Bragendesh/RB-Macro16/README.md

# RB-Macro16
A basic 16-key macropad with an optional spot for a rotary encoder and per-key RGB backlighting
