Bragendesh/RB-Macro16/232202_RB-Macro16_Schematic.png

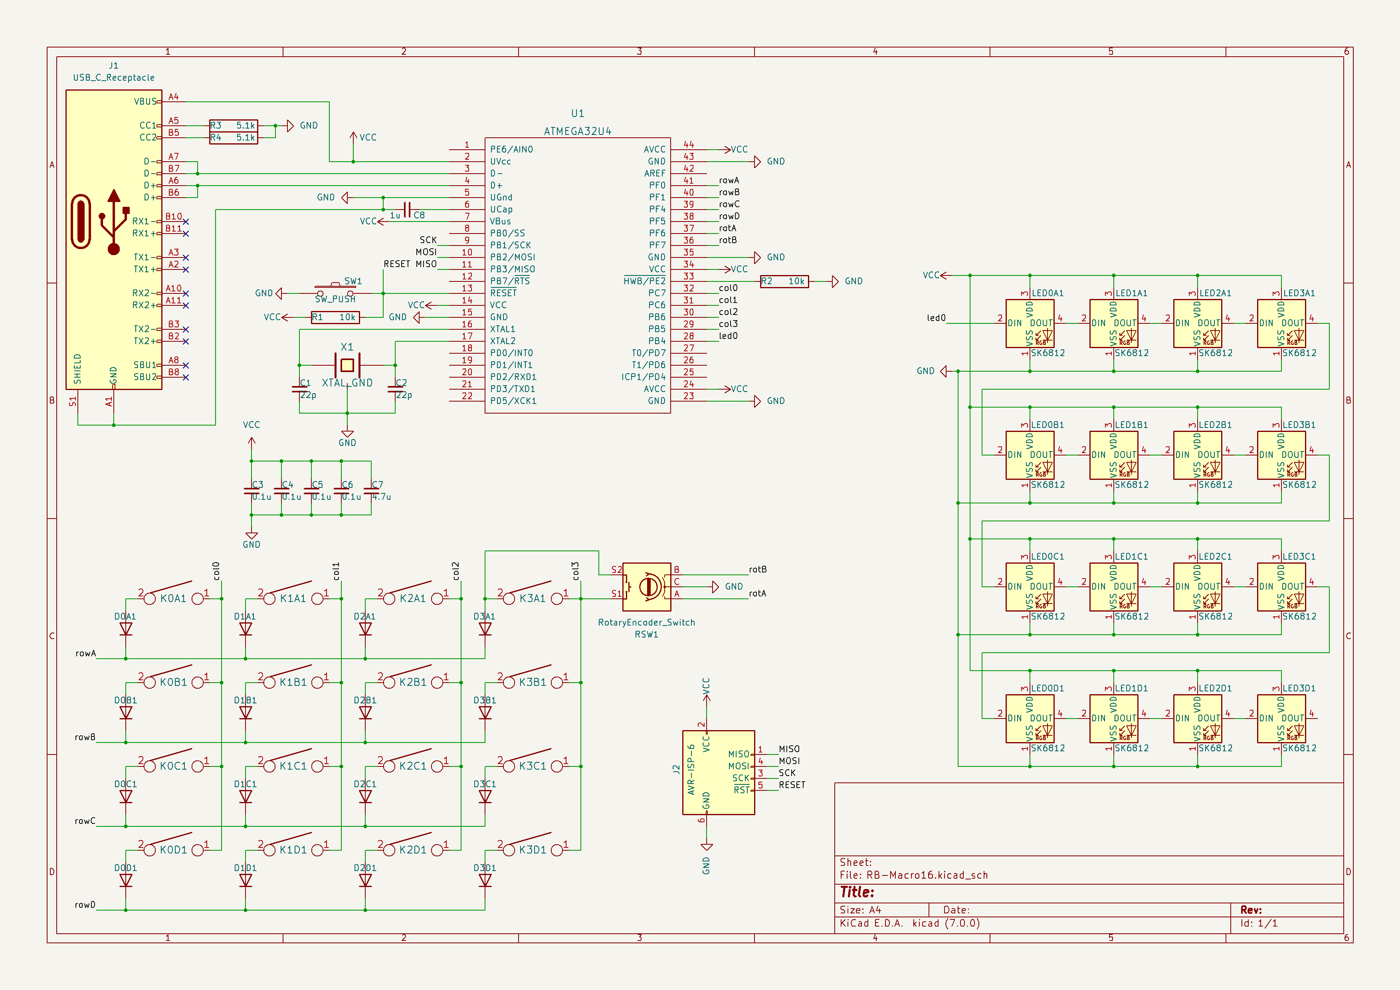
232202_RB-Macro16_Schematic.png
