Bragendesh/RB-Macro16/KiCad Project/RB-Macro16.kicad_pcb

## KiCad design KiCad Project/RB-Macro16.kicad_pcb (2023-03-09)

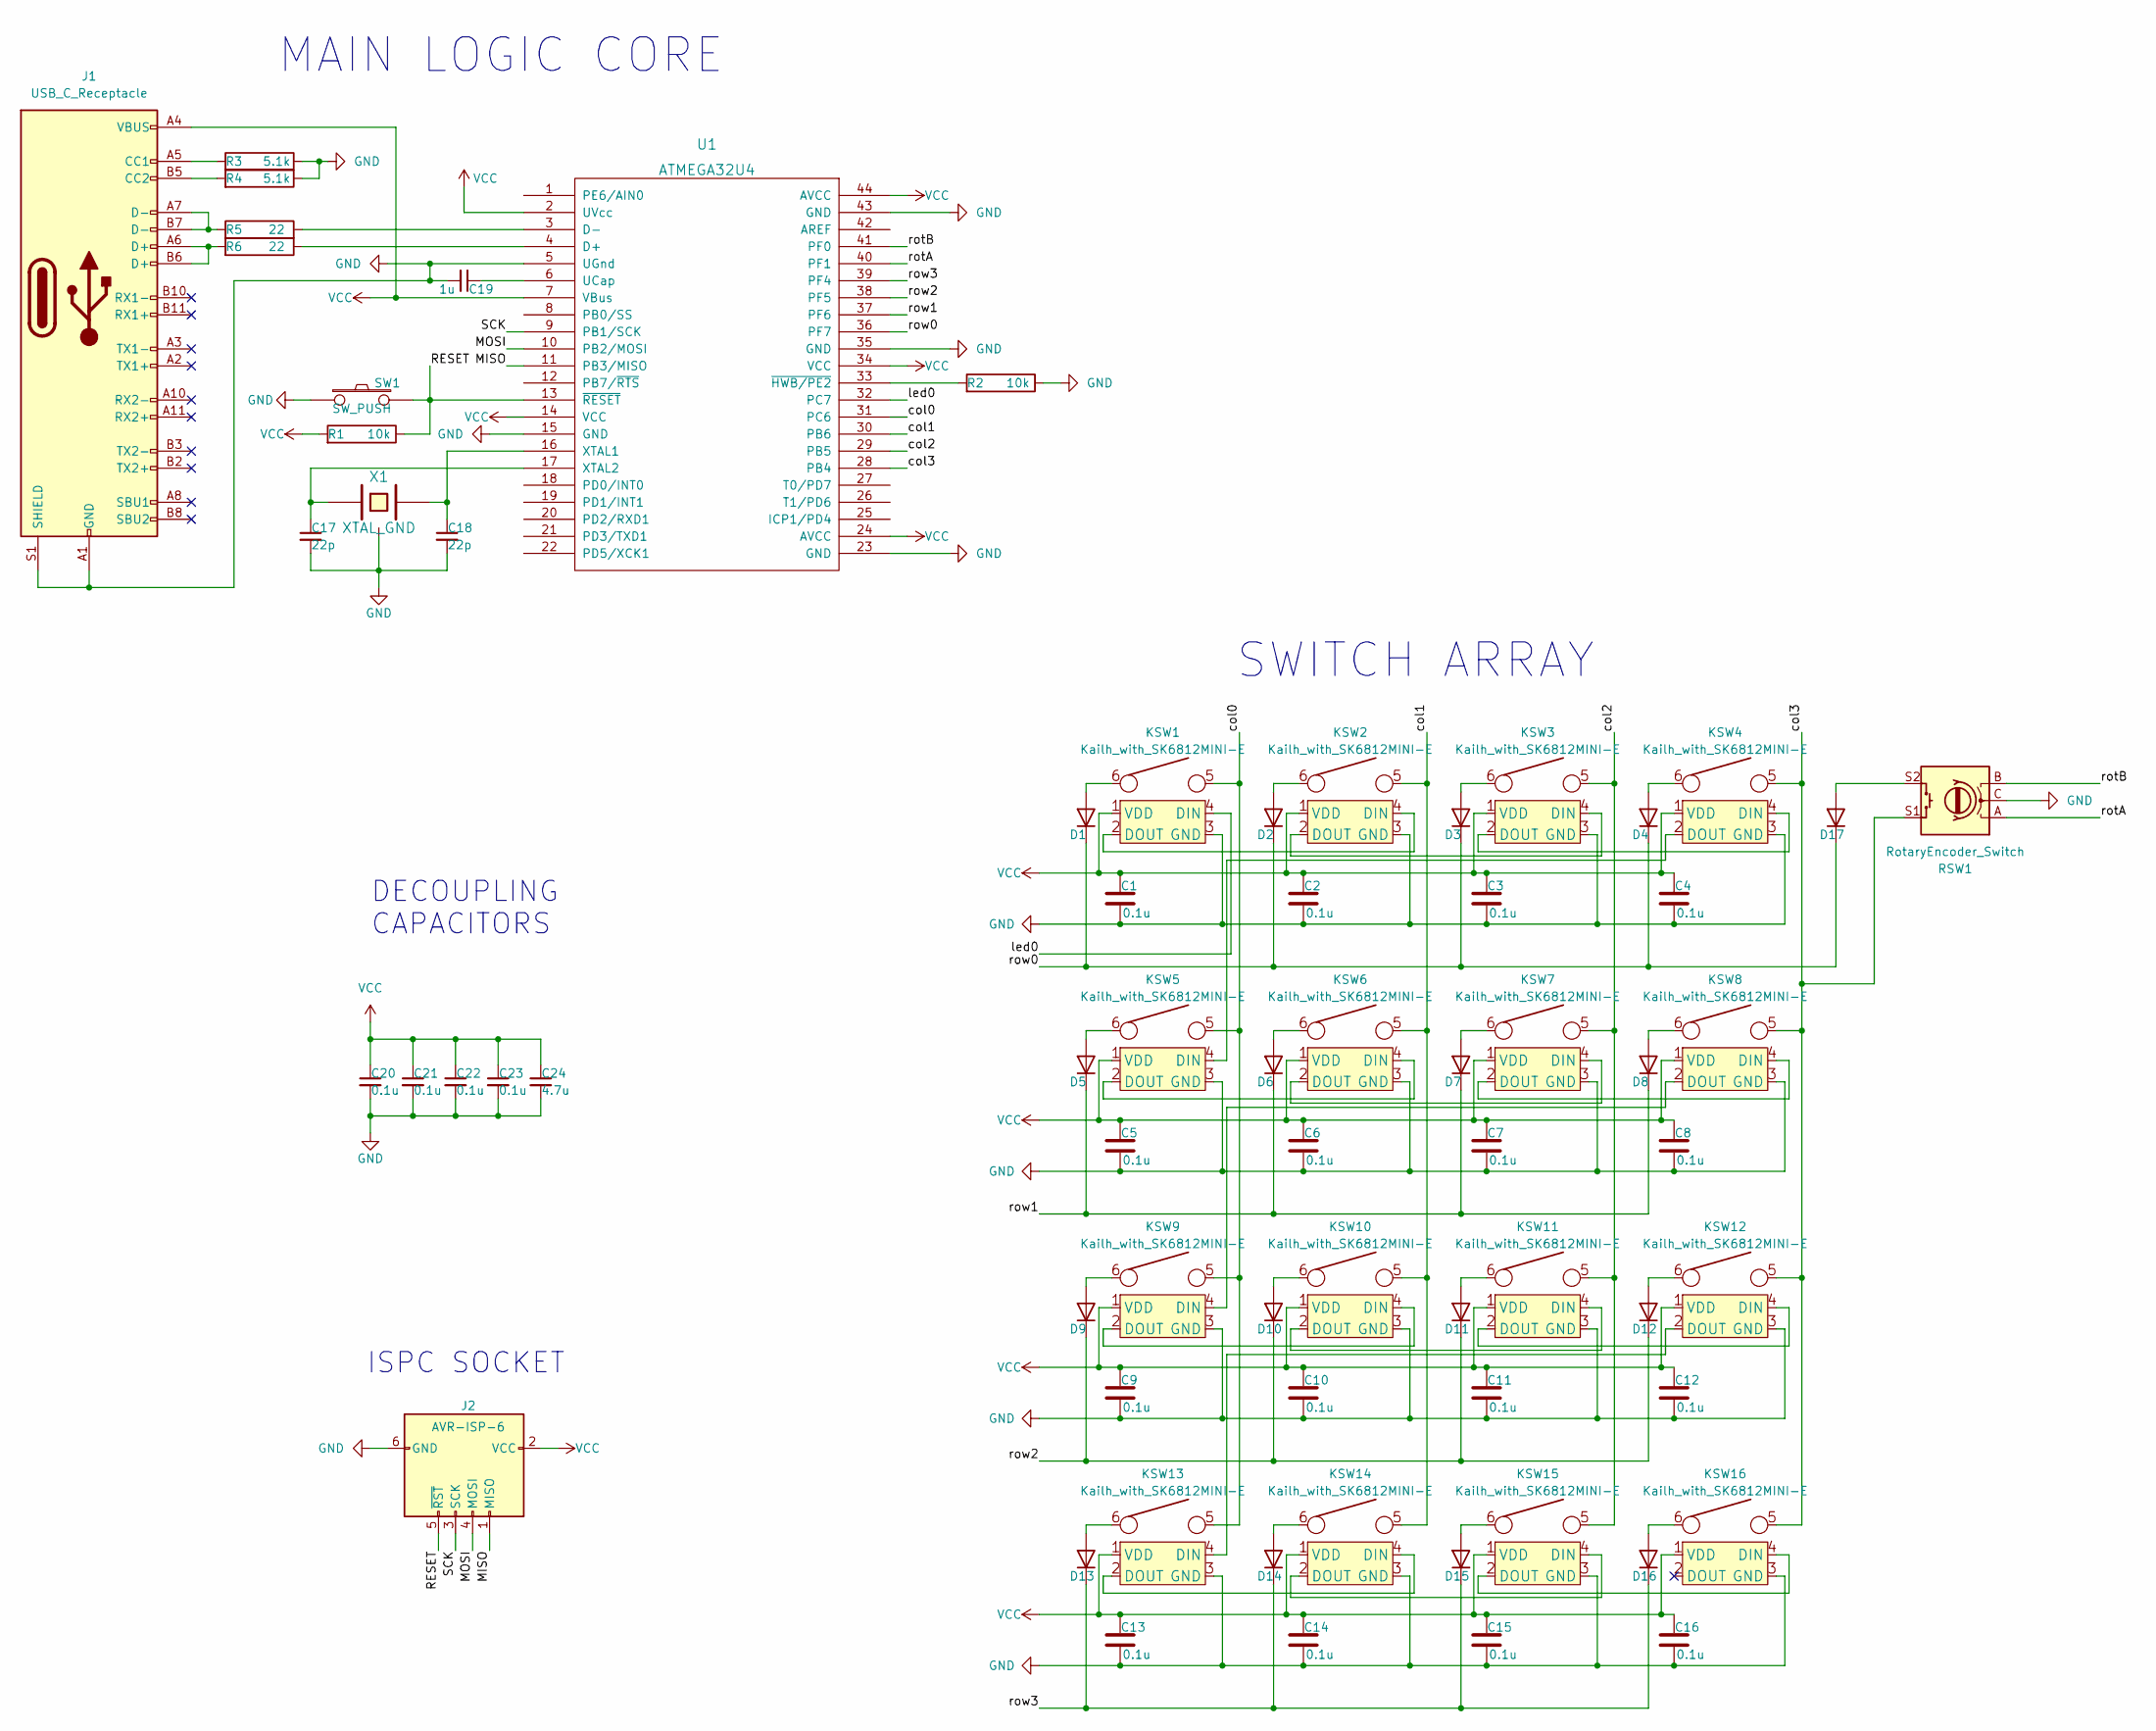
[picture p2: schematic RB-Macro16.kicad_sch]

Parts:
C1, C2, C3, C4, C5, C6, C7, C8, C9, C10, C11, C12, C13, C14, C15, C16, C20, C21, C22, C23: 0.1u; C_0805_2012Metric_Pad1.18x1.45mm_HandSolder
C17, C18: 22p; C_0805_2012Metric_Pad1.18x1.45mm_HandSolder
C19: 1u; C_0805_2012Metric_Pad1.18x1.45mm_HandSolder
C24: 4.7u; C_0805_2012Metric_Pad1.18x1.45mm_HandSolder
D1, D2, D3, D4, D5, D6, D7, D8, D9, D10, D11, D12, D13, D14, D15, D16, D17: D; D_SOD-123
J1: USB_C_Receptacle; USB_C_Receptacle_Amphenol_12401610E4-2A
J2: AVR-ISP-6; AVR_ICSP_3x2
KSW1, KSW2, KSW3, KSW4, KSW5, KSW6, KSW7, KSW8, KSW9, KSW10, KSW11, KSW12, KSW13, KSW14, KSW15, KSW16: Kailh_with_SK6812MINI-E
R1, R2: 10k; R_Axial_DIN0207_L6.3mm_D2.5mm_P7.62mm_Horizontal
R3, R4: 5.1k; R_Axial_DIN0207_L6.3mm_D2.5mm_P7.62mm_Horizontal
R5, R6: 22; R_Axial_DIN0207_L6.3mm_D2.5mm_P7.62mm_Horizontal
RSW1: RotaryEncoder_Switch; RotaryEncoder_Alps_EC12E-Switch_Vertical_H20mm
SW1: SW_PUSH; SW_PUSH_6mm
U1: ATMEGA32U4; TQFP-44_10x10mm_P0.8mm
X1: XTAL_GND; Crystal_SMD_SeikoEpson_FA238-4Pin_3.2x2.5mm_HandSoldering

Connections:
/MISO: J2.1 (MISO), U1.11 (PB3/MISO)
/MOSI: J2.4 (MOSI), U1.10 (PB2/MOSI)
/RESET: J2.5 (~RST), R1.2, SW1.2, U1.13 (~RESET)
/SCK: J2.3 (SCK), U1.9 (PB1/SCK)
/col0: KSW1.5, KSW5.5, KSW9.5, KSW13.5, U1.31 (PC6)
/col1: KSW2.5, KSW6.5, KSW10.5, KSW14.5, U1.30 (PB6)
/col2: KSW3.5, KSW7.5, KSW11.5, KSW15.5, U1.29 (PB5)
/col3: KSW4.5, KSW8.5, KSW12.5, KSW16.5, RSW1.S1, U1.28 (PB4)
/led0: KSW1.4 (DIN), U1.32 (PC7)
/rotA: RSW1.A, U1.40 (PF1)
/rotB: RSW1.B, U1.41 (PF0)
/row0: D1.1 (K), D2.1 (K), D3.1 (K), D4.1 (K), D17.1 (K), U1.36 (PF7)
/row1: D5.1 (K), D6.1 (K), D7.1 (K), D8.1 (K), U1.37 (PF6)
/row2: D9.1 (K), D10.1 (K), D11.1 (K), D12.1 (K), U1.38 (PF5)
/row3: D13.1 (K), D14.1 (K), D15.1 (K), D16.1 (K), U1.39 (PF4)
GND: C1.2, C2.2, C3.2, C4.2, C5.2, C6.2, C7.2, C8.2, C9.2, C10.2, C11.2, C12.2, C13.2, C14.2, C15.2, C16.2, C17.2, C18.2, C19.2, C20.2, C21.2, C22.2, C23.2, C24.2, J1.A1 (GND), J1.A12 (GND), J1.B1 (GND), J1.B12 (GND), J1.S1 (SHIELD), J2.6 (GND), KSW1.3 (GND), KSW2.3 (GND), KSW3.3 (GND), KSW4.3 (GND), KSW5.3 (GND), KSW6.3 (GND), KSW7.3 (GND), KSW8.3 (GND), KSW9.3 (GND), KSW10.3 (GND), KSW11.3 (GND), KSW12.3 (GND), KSW13.3 (GND), KSW14.3 (GND), KSW15.3 (GND), KSW16.3 (GND), R2.2, R3.2, R4.2, RSW1.C, SW1.1, U1.5 (UGnd), U1.15 (GND), U1.23 (GND), U1.35 (GND), U1.43 (GND), X1.3
unnamed: D1.2 (A), KSW1.6
unnamed: D2.2 (A), KSW2.6
unnamed: D3.2 (A), KSW3.6
unnamed: D4.2 (A), KSW4.6
unnamed: D5.2 (A), KSW5.6
unnamed: D6.2 (A), KSW6.6
unnamed: D7.2 (A), KSW7.6
unnamed: D8.2 (A), KSW8.6
unnamed: D9.2 (A), KSW9.6
unnamed: D10.2 (A), KSW10.6
unnamed: D11.2 (A), KSW11.6
unnamed: D12.2 (A), KSW12.6
unnamed: D13.2 (A), KSW13.6
unnamed: D14.2 (A), KSW14.6
unnamed: D15.2 (A), KSW15.6
unnamed: D16.2 (A), KSW16.6
unnamed: D17.2 (A), RSW1.S2
unnamed: J1.A5 (CC1), R3.1
unnamed: J1.B5 (CC2), R4.1
unnamed: J1.A6 (D+), J1.B6 (D+), R6.1
unnamed: J1.A7 (D-), J1.B7 (D-), R5.1
unnamed: KSW1.2 (DOUT), KSW2.4 (DIN)
unnamed: KSW2.2 (DOUT), KSW3.4 (DIN)
unnamed: KSW3.2 (DOUT), KSW4.4 (DIN)
unnamed: KSW4.2 (DOUT), KSW5.4 (DIN)
unnamed: KSW5.2 (DOUT), KSW6.4 (DIN)
unnamed: KSW6.2 (DOUT), KSW7.4 (DIN)
unnamed: KSW7.2 (DOUT), KSW8.4 (DIN)
unnamed: KSW8.2 (DOUT), KSW9.4 (DIN)
unnamed: KSW9.2 (DOUT), KSW10.4 (DIN)
unnamed: KSW10.2 (DOUT), KSW11.4 (DIN)
unnamed: KSW11.2 (DOUT), KSW12.4 (DIN)
unnamed: KSW12.2 (DOUT), KSW13.4 (DIN)
unnamed: KSW13.2 (DOUT), KSW14.4 (DIN)
unnamed: KSW14.2 (DOUT), KSW15.4 (DIN)
unnamed: KSW15.2 (DOUT), KSW16.4 (DIN)
unnamed: R6.2, U1.4 (D+)
unnamed: R5.2, U1.3 (D-)
unnamed: C19.1, U1.6 (UCap)
unnamed: C18.1, U1.16 (XTAL1), X1.2
unnamed: C17.1, U1.17 (XTAL2), X1.1
unnamed: R2.1, U1.33 (~HWB/PE2)
VCC: C1.1, C2.1, C3.1, C4.1, C5.1, C6.1, C7.1, C8.1, C9.1, C10.1, C11.1, C12.1, C13.1, C14.1, C15.1, C16.1, C20.1, C21.1, C22.1, C23.1, C24.1, J1.A4 (VBUS), J1.A9 (VBUS), J1.B4 (VBUS), J1.B9 (VBUS), J2.2 (VCC), KSW1.1 (VDD), KSW2.1 (VDD), KSW3.1 (VDD), KSW4.1 (VDD), KSW5.1 (VDD), KSW6.1 (VDD), KSW7.1 (VDD), KSW8.1 (VDD), KSW9.1 (VDD), KSW10.1 (VDD), KSW11.1 (VDD), KSW12.1 (VDD), KSW13.1 (VDD), KSW14.1 (VDD), KSW15.1 (VDD), KSW16.1 (VDD), R1.1, U1.2 (UVcc), U1.7 (VBus), U1.14 (VCC), U1.24 (AVCC), U1.34 (VCC), U1.44 (AVCC)

Notes on the sheet:
MAIN LOGIC CORE
ISPC SOCKET
DECOUPLING CAPACITORS
SWITCH ARRAY

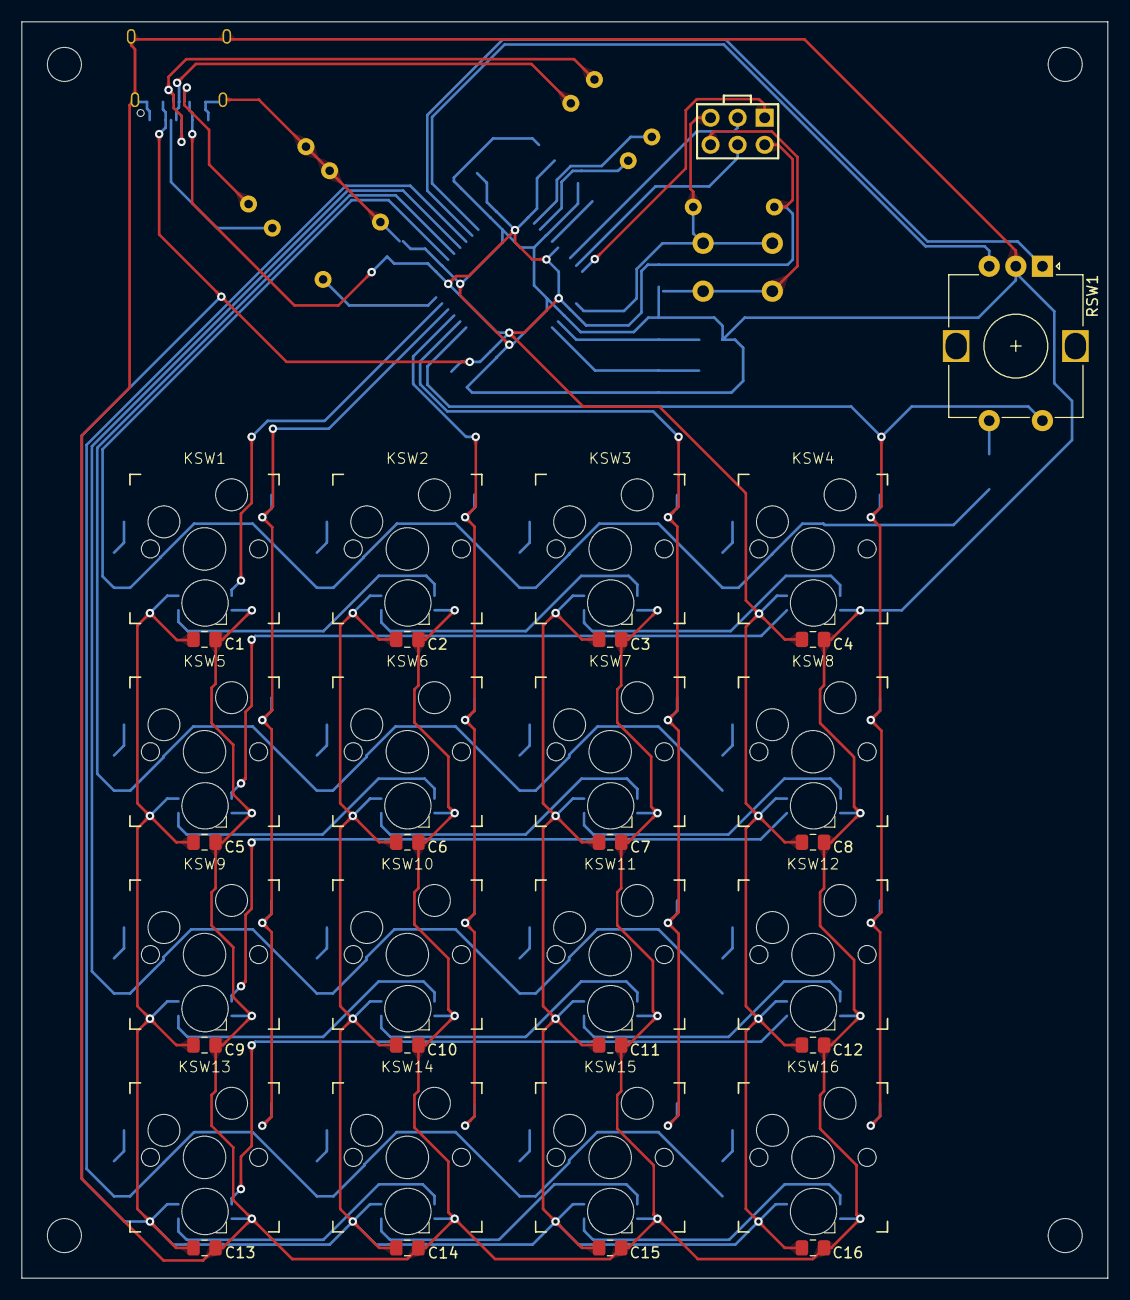
[picture p3: board RB-Macro16.kicad_pcb from above]

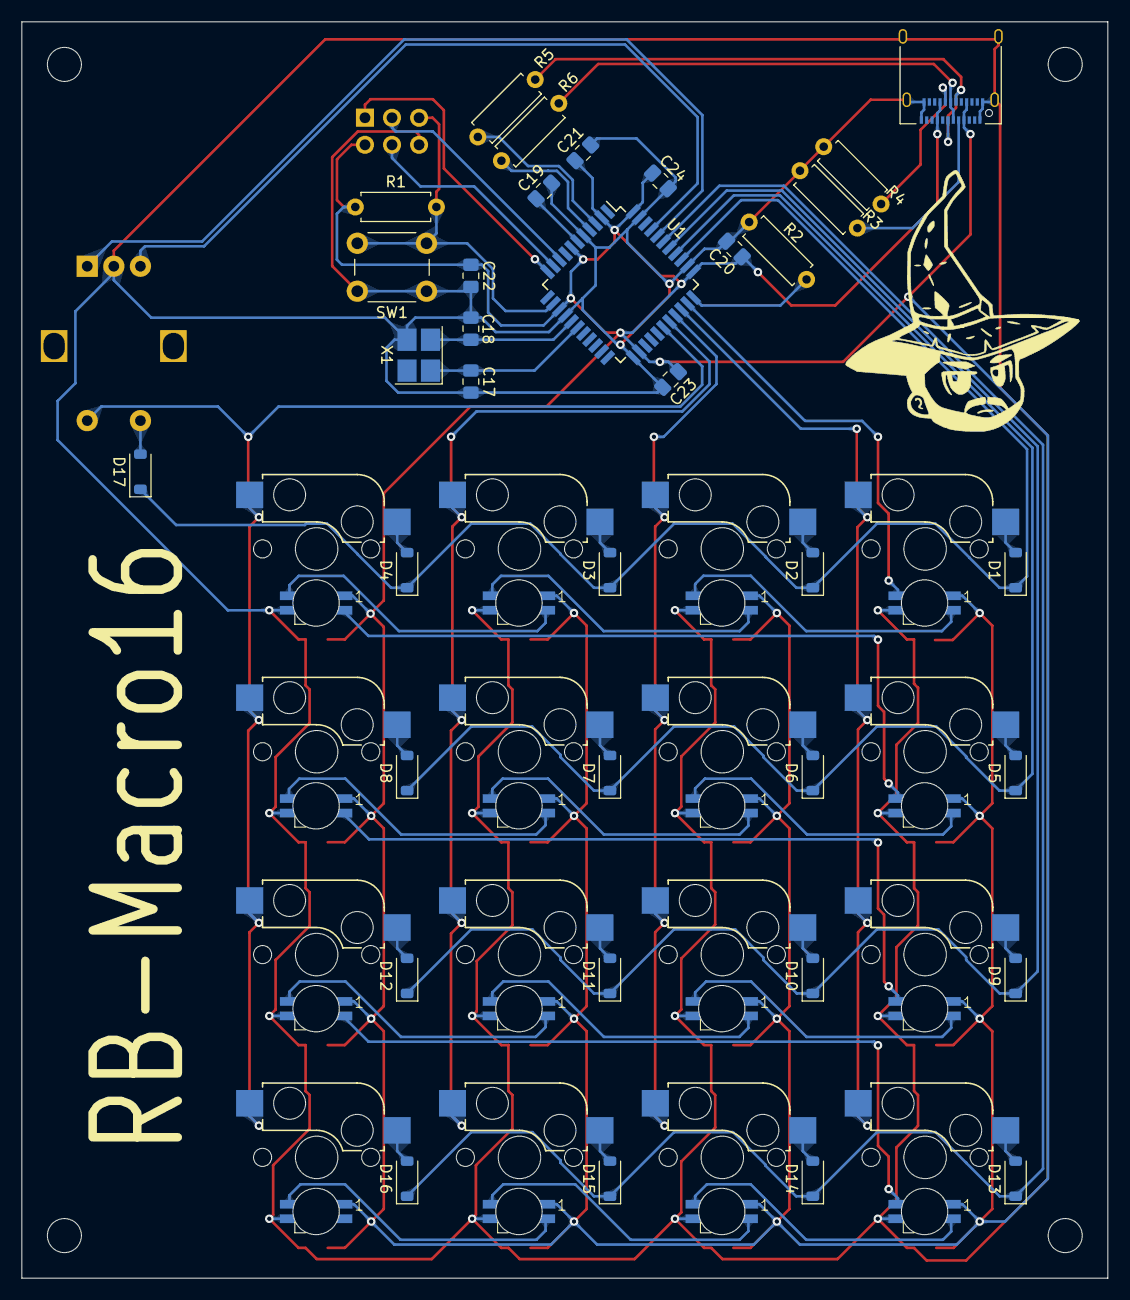
[picture p4: board RB-Macro16.kicad_pcb from below]

Board: 2 copper layers, 102.0 x 118.0 mm, 69 parts (35 on the bottom side), 59 nets.
