Bragendesh/RB-Macro16/(commit log)

2023-02-22 Schematic Design Initial
    Drew out the entire initial schematic including microcontroller, key switches, LEDs, and USB C receptacle.
    [RB-Macro16.kicad_pcb, RB-Macro16.kicad_sch]
2023-02-22 Finished Schematic
    Finished the schematic and associated all footprints to prep for PCB design
    [RB-Macro16.kicad_sch]
2023-02-22 New Switch Found
    Found a new MX Switch with LITEON LEDs
    [RB-Macro16.kicad_pcb, RB-Macro16.kicad_sch]
2023-02-22 Abandoned New Swtich
    Can't find LED new switch footprint uses. Began working on footprint for SK6812MINI-E from Adafruit as a replacement. Added capacitors to LED array and rebuilt it.
    [RB-Macro16.kicad_pcb, RB-Macro16.kicad_sch]
2023-02-23 New Switch Symbol and Footprint
    Redid switch symbol and footprint to combine hot swap footprint and reverse mount LED footprint. Started work on PCB, laying out switches, diodes, capacitors
    [RB-Macro16.kicad_pcb, RB-Macro16.kicad_sch]
2023-02-24 Routed PCB
    Routed most of the traces in the PCB for the switch block. uP in progress.
    [RB-Macro16.kicad_pcb, RB-Macro16.kicad_sch]
2023-02-24 Generated BOM
    BOM
    [RB-Macro16.csv, RB-Macro16.kicad_sch]
2023-03-02 Placed ATMEGA
    Placed ATMEGA and XTAL and caps and routed traces to them
    [RB-Macro16.kicad_pcb, RB-Macro16.kicad_sch]
2023-03-08 Minor Changes
    [RB-Macro16.kicad_pcb]
2023-03-08 Finished Traces
    Completed all traces
    [RB-Macro16.kicad_pcb]
2023-03-09 Added Graphics and Finalized
    Added a graphic and finalized the design including integrity checks. Generated Gerber files.
    [RB-Macro16-B_Cu.gbr, RB-Macro16-B_Mask.gbr, RB-Macro16-B_Paste.gbr, RB-Macro16-B_Silkscreen.gbr, RB-Macro16-Edge_Cuts.gbr, RB-Macro16-F_Cu.gbr, RB-Macro16-F_Mask.gbr, RB-Macro16-F_Paste.gbr]
